xxpESP32/STC32G_Power_USB/硬件电路/PCB图.png

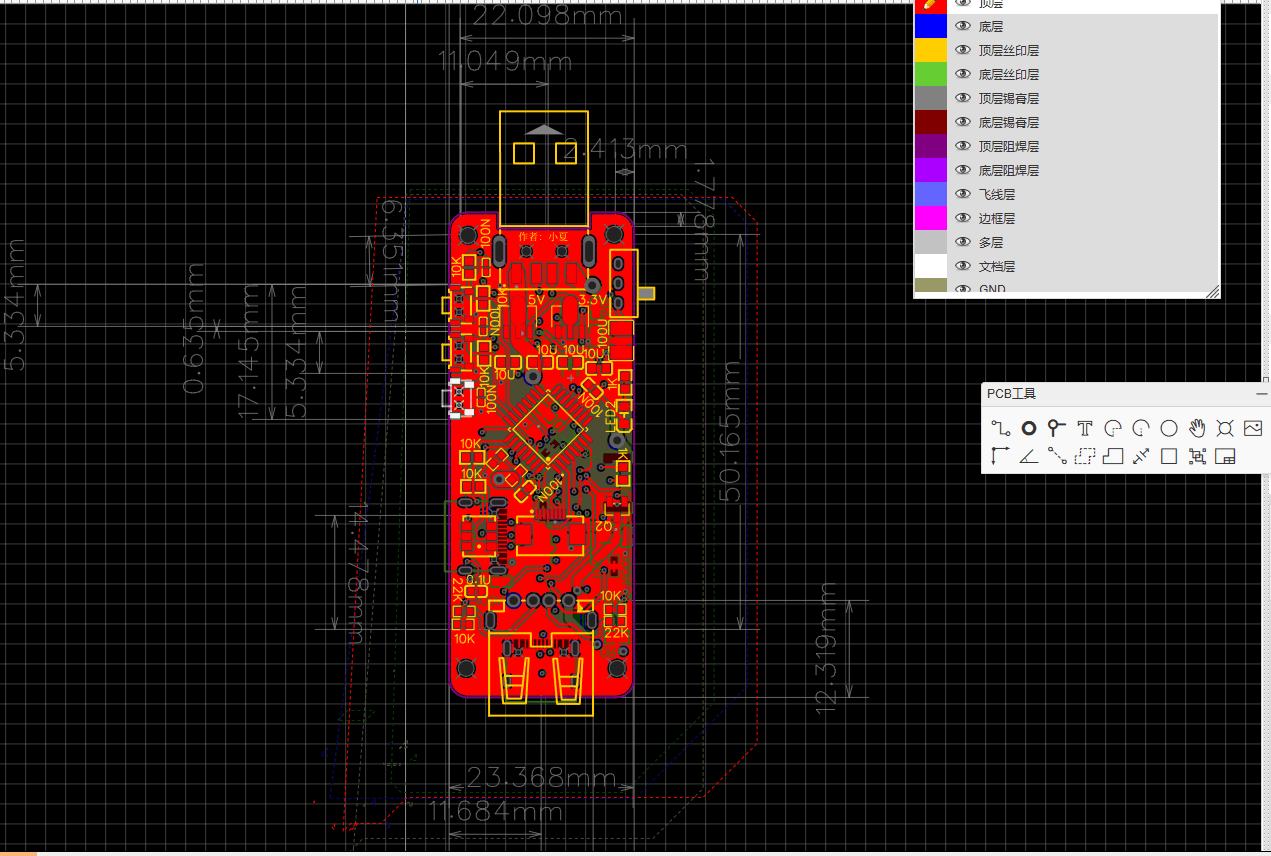
硬件电路/PCB图.png
