xxpESP32/STC32G_Power_USB/硬件电路/硬件原理图.png

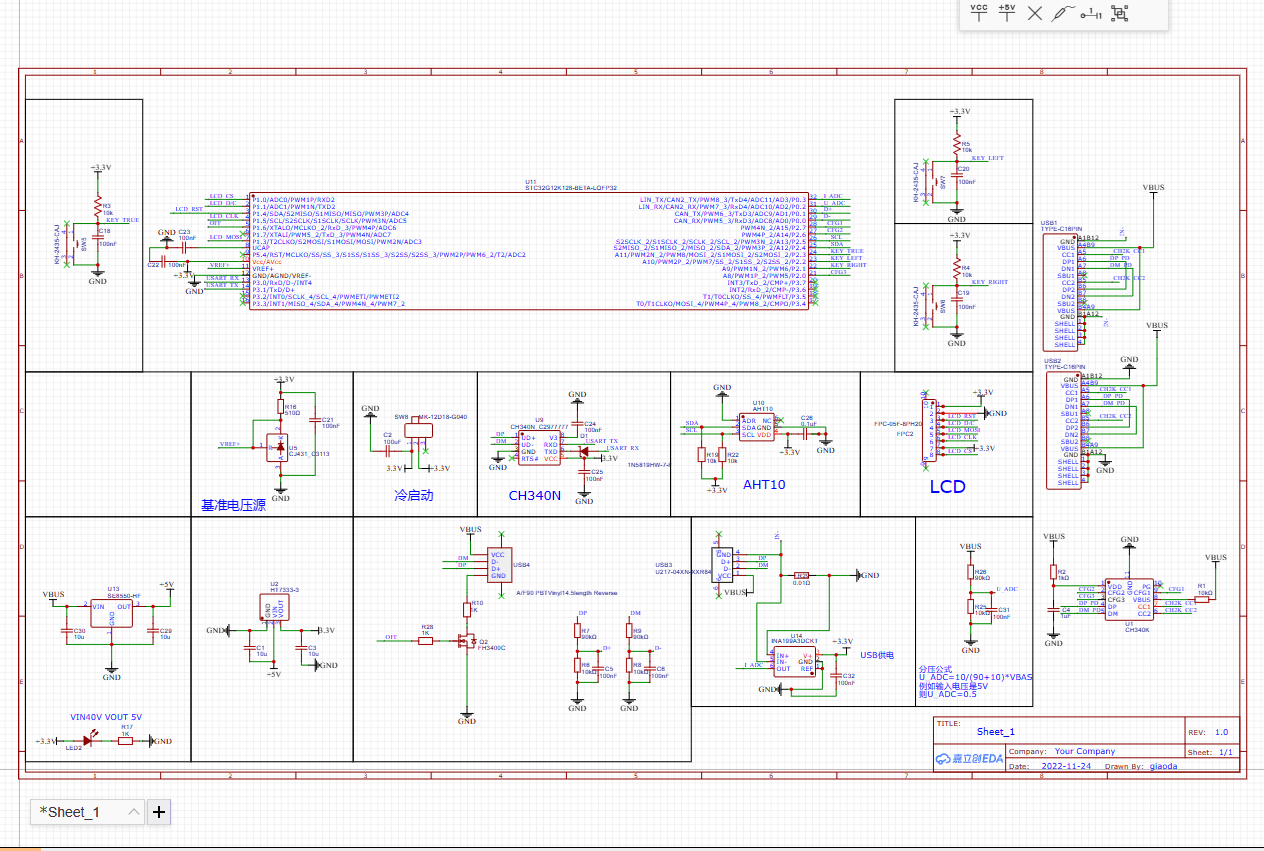
硬件电路/硬件原理图.png
