xxpESP32/STC32G_Power_USB/硬件电路/BOM_[STC32G12K128] V.2.0_2023-02-16.csv

ID | Name | Designator | Footprint | Quantity | Manufacturer Part | Manufacturer | Supplier | Supplier Part | Price | Pins
1 | 10u | C1,C3,C29,C30 | C0603 | 4 |  |  |  |  |  | 2
2 | 100uF | C2 | C1210 | 1 | GRM32EE70G107ME19L | muRata(村田) | LCSC | C711057 | 2.1388 | 2
3 | 1uF | C4 | C0603 | 1 | CC0603KRX5R8BB105 | YAGEO | LCSC | C14664 | 0.0331 | 2
4 | 100nF | C5,C6,C21,C22,C23,C24,C25,C31,C32 | C0603 | 9 | CL10B104KC8NNNC | SAMSUNG | LCSC | C15725 | 0.0462 | 2
5 | 100nF | C18,C19,C20 | C0402 | 3 | GCM155R71C104KA55J | muRata(村田) | LCSC | C2655418 | 0.0395 | 2
6 | 0.1uF | C26 | C0603 | 1 | 0603BB104K500NGT | Knowles(楼氏) | LCSC | C2168571 | 30.36 | 2
7 | 1N5819HW-7-F | D1 | SOD-123_L2.8-W1.8-LS3.7-FD | 1 | 1N5819HW-7-F | DIODES | LCSC | C82544 | 0.1569 | 2
8 | FPC-05F-8PH20 | FPC2 | FPC-SMD_8P-P0.50_FPC-05F-8PH20 | 1 | FPC-05F-8PH20 | XUNPU(讯普) | LCSC | C2856797 | 0.5247 | 10
9 | 204-10SURD/S530-A3 | LED2 | LED0805-RD | 1 | 204-10SURD/S530-A3 | EVERLIGHT | LCSC | C99772 | 0.2313 | 2
10 | FH3400C | Q2 | SOT-23-3_L2.9-W1.3-P1.90-LS2.4-BR | 1 | FH3400C | 鑫飞宏 | LCSC | C2940037 | 0.2404 | 3
11 | 10kΩ | R1,R6,R8,R25 | R0603 | 4 | RMC06036.8K5%N | Tyohm | LCSC | C269697 | 0.019 | 2
12 | 1kΩ | R2 | R0603 | 1 | MCWF06R1001BTL | Multicomp | LCSC | C241300 | 1.4764 | 2
13 | 10k | R3,R4,R5,R19,R22 | R0603 | 5 |  |  |  |  |  | 2
14 | 90kΩ | R7,R9,R26 | R0603 | 3 | RMC06036.8K5%N | Tyohm | LCSC | C269697 | 0.019 | 2
15 | 1K | R10,R17,R28 | R0603 | 3 |  |  |  |  |  | 2
16 | 510Ω | R16 | R0603 | 1 | 0603WAJ0000T5E | UniOhm | LCSC | C15402 | 0.0067 | 2
17 | 0.01Ω | R29 | R2512 | 1 | FMF25JPJR010-LHL | PSA | LCSC | C105370 | 0.3029 | 2
18 | KH-2435-CAJ | SW5,SW6,SW7 | SW-SMD_KH-2435-CAJ | 3 | KH-2435-CAJ | kinghelm(金航标) | LCSC | C530669 | 0.2322 | 4
19 | MK-12D18-G040 | SW8 | SW-TH_MK-12D18-G040 | 1 | MK-12D18-G040 | G-Switch | LCSC | C963202 | 0.6701 | 3
20 | CH340K | U1 | ESOP-10_L4.9-W3.9-P1.00-LS6.2-BL-EP | 1 | CH340K | WCH(Jiangsu Qin Heng) | LCSC | C968586 | 4.46 | 11
21 | HT7333-3 | U2 | SOT-89-3_L4.5-W2.5-P1.50-LS4.2-BR | 1 | HT7333-3 | HOLTEK(台湾合泰/盛群) | LCSC | C84207 | 1.8944 | 3
22 | CJ431_C3113 | U5 | SOT-23-3_L2.9-W1.6-P1.90-LS2.8-BR | 1 | CJ431 | CJ | LCSC | C3113 | 0.2165 | 3
23 | CH340N_C2977777 | U9 | SOP-8_L4.9-W3.9-P1.27-LS6.0-BL | 1 | CH340N | WCH(南京沁恒) | LCSC | C2977777 | 3.19 | 8
24 | AHT10 | U10 | SENSOR-SMD_AHT10 | 1 | AHT10 | 广州奥松 | LCSC | C368909 | 4.85 | 6
25 | STC32G12K128-BETA-LQFP32 | U11 | LQFP-32_L7.0-W7.0-P0.80-LS9.0-BL | 1 | STC32G12K128-Beta-LQFP32 | STC(宏晶) | LCSC | C3020369 | 8.8 | 32
26 | SE8550-HF | U13 | SOT-89-3_L4.5-W2.5-P1.50-LS4.2-BR | 1 | SE8550-HF | SEAWARD | LCSC | C115012 | 0.9356 | 3
27 | INA199A3DCKT | U14 | SC-70-6_L2.1-W1.3-P0.65-LS2.1-BR | 1 | INA199A3DCKT | TI(德州仪器) | LCSC | C2155798 | 6.19 | 6
28 | TYPE-C16PIN | USB1,USB2 | USB-C-SMD_TYPE-C16PIN | 2 | TYPE-C16PIN | SHOU HAN | LCSC | C393939 | 1.3293 | 16
29 | U217-04XN-XXR84 | USB3 | USB-A-SMD_U217-041N-4BV81 | 1 | U217-041N-4BV81 | XKB Connectivity(中国星坤) | LCSC | C319178 | 0.3553 | 6
30 | A/F90 PBTVinyl14.5length Reverse | USB4 | USB-A-TH_USB-M-57 | 1 | A/F90 PBTVinyl14.5length Reverse | ValuePro | LCSC | C42662 | 0.5702 | 6
