xxpESP32/STC32G_Power_USB/(list of files, cad)

Other CAD files:
实战-电流计_V1.0.2/Objects/main.obj
实战-电流计_V1.0.2/Objects/uart1.obj
实战-电流计_V1.0.2/Objects/usart2.obj
实战-电流计_V1.0.2/Objects/AHT10.obj
实战-电流计_V1.0.2/Objects/Spi_Handler.obj
实战-电流计_V1.0.2/Objects/CH224K.obj
实战-电流计_V1.0.2/Objects/Pwm.obj
实战-电流计_V1.0.2/Objects/SYSTEM.obj
实战-电流计_V1.0.2/Objects/lcd_init.obj
实战-电流计_V1.0.2/Objects/ADC.obj
实战-电流计_V1.0.2/Objects/menu_Ui.obj
实战-电流计_V1.0.2/Objects/Timer.obj
实战-电流计_V1.0.2/Objects/lcd.obj
实战-电流计_V1.0.2/Objects/KEY.obj
实战-电流计_V1.0.2/Objects/menu.obj
实战-电流计_V1.0.2/Objects/I2C.obj
