xxpESP32/STC32G_Power_USB/实战-电流计_V1.0.2/LCD/lcdfont.h

#ifndef __LCDFONT_H
#define __LCDFONT_H 	   

const unsigned char code ascii_1206[][12]={

{0x00,0x00,0x00,0x00,0x00,0x00,0x00,0x00,0x00,0x00,0x00,0x00},/*" ",0*/
{0x00,0x00,0x04,0x04,0x04,0x04,0x04,0x00,0x00,0x04,0x00,0x00},/*"!",1*/
{0x14,0x14,0x0A,0x00,0x00,0x00,0x00,0x00,0x00,0x00,0x00,0x00},/*""",2*/
{0x00,0x00,0x0A,0x0A,0x1F,0x0A,0x0A,0x1F,0x0A,0x0A,0x00,0x00},/*"#",3*/
{0x00,0x04,0x0E,0x15,0x05,0x06,0x0C,0x14,0x15,0x0E,0x04,0x00},/*"$",4*/
{0x00,0x00,0x12,0x15,0x0D,0x15,0x2E,0x2C,0x2A,0x12,0x00,0x00},/*"%",5*/
{0x00,0x00,0x04,0x0A,0x0A,0x36,0x15,0x15,0x29,0x16,0x00,0x00},/*"&",6*/
{0x02,0x02,0x01,0x00,0x00,0x00,0x00,0x00,0x00,0x00,0x00,0x00},/*"'",7*/
{0x10,0x08,0x08,0x04,0x04,0x04,0x04,0x04,0x08,0x08,0x10,0x00},/*"(",8*/
{0x02,0x04,0x04,0x08,0x08,0x08,0x08,0x08,0x04,0x04,0x02,0x00},/*")",9*/
{0x00,0x00,0x00,0x04,0x15,0x0E,0x0E,0x15,0x04,0x00,0x00,0x00},/*"*",10*/
{0x00,0x00,0x00,0x08,0x08,0x3E,0x08,0x08,0x00,0x00,0x00,0x00},/*"+",11*/
{0x00,0x00,0x00,0x00,0x00,0x00,0x00,0x00,0x02,0x02,0x01,0x00},/*",",12*/
{0x00,0x00,0x00,0x00,0x00,0x3F,0x00,0x00,0x00,0x00,0x00,0x00},/*"-",13*/
{0x00,0x00,0x00,0x00,0x00,0x00,0x00,0x00,0x00,0x02,0x00,0x00},/*".",14*/
{0x00,0x20,0x10,0x10,0x08,0x08,0x04,0x04,0x02,0x02,0x01,0x00},/*"/",15*/
{0x00,0x00,0x0E,0x11,0x11,0x11,0x11,0x11,0x11,0x0E,0x00,0x00},/*"0",16*/
{0x00,0x00,0x04,0x06,0x04,0x04,0x04,0x04,0x04,0x0E,0x00,0x00},/*"1",17*/
{0x00,0x00,0x0E,0x11,0x11,0x08,0x04,0x02,0x01,0x1F,0x00,0x00},/*"2",18*/
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
0x40,0x8C,0x31,0x06,0x60,0x8C,0x31,0x06,0x7C,0x8C,0x31,0x06,0x70,0x8C,0x31,0x06,
0x30,0x8C,0x31,0x06,0x30,0x8C,0x31,0x06,0x30,0x8C,0x31,0x06,0x30,0x8C,0x31,0x06,
0x30,0x8C,0x31,0x36,0xB0,0xFF,0xFF,0x3F,0x00,0x00,0x00,0x00,0x00,0x00,0x00,0x00,/*"温",2*/
/* (32 X 32 , 宋体 )*/

"度",0x00,0x00,0x00,0x00,0x00,0x00,0x00,0x00,0x00,0x80,0x00,0x00,0x00,0x00,0x03,0x00,
0x00,0x00,0x07,0x08,0x20,0x00,0x02,0x1C,0xE0,0xFF,0xFF,0x3F,0x60,0x20,0x20,0x00,
0x60,0xE0,0xE0,0x00,0x60,0x60,0x60,0x00,0x60,0x60,0x60,0x0C,0xE0,0xFF,0xFF,0x1F,
0x60,0x60,0x60,0x00,0x60,0x60,0x60,0x00,0x60,0x60,0x60,0x00,0x60,0x60,0x60,0x00,
0x60,0xE0,0x7F,0x00,0x60,0x60,0x60,0x00,0x20,0x00,0x80,0x00,0x20,0xFC,0xFF,0x01,
0x30,0x20,0xC0,0x01,0x30,0x40,0xE0,0x00,0x30,0xC0,0x60,0x00,0x10,0x80,0x30,0x00,
0x10,0x00,0x1B,0x00,0x18,0x00,0x0E,0x00,0x08,0x00,0x1F,0x00,0x08,0xC0,0x79,0x00,
0x04,0x70,0xE0,0x1F,0x04,0x0E,0x00,0x1F,0xE2,0x01,0x00,0x08,0x00,0x00,0x00,0x00,/*"度",3*/
/* (32 X 32 , 宋体 )*/






/* (32 X 32 , 宋体 )*/	

};

#endif
