xxpESP32/STC32G_Power_USB/实战-电流计_V1.0.2/LCD/lcd_init.c

#include "lcd_init.h"
#include "system.h"
#include "SPI_Handler.h"

#define SYS_CLK 35000000L
//不准确延时函数



/******************************************************************************
      函数说明：LCD串行数据写入函数
      入口数据：dat  要写入的串行数据
      返回值：  无
******************************************************************************/
#if SOFTWARE

void LCD_Writ_Bus(u8 dat) 
{	
	u8 i;
	LCD_CS_Clr();
	for(i=0;i<8;i++)
	{			  
		LCD_SCLK_Clr();
		if(dat&0x80)
		{
		   LCD_MOSI_Set();
		}
		else
		{
		   LCD_MOSI_Clr();
		}
		LCD_SCLK_Set();
		dat<<=1;
	}	
  LCD_CS_Set();	
}
#else
void LCD_Writ_Bus(u8 dat){
	LCD_CS_Clr();
	SPDAT=dat;
	while(!SPIF);
	SPIF=1;
	LCD_CS_Set();	
}
#endif
/******************************************************************************
      函数说明：LCD写入数据
      入口数据：dat 写入的数据
      返回值：  无
******************************************************************************/
void LCD_WR_DATA8(u8 dat)
{
	LCD_Writ_Bus(dat);
}


/******************************************************************************
      函数说明：LCD写入数据
      入口数据：dat 写入的数据
      返回值：  无
******************************************************************************/
void LCD_WR_DATA(u16 dat)
{
	LCD_Writ_Bus(dat>>8);
	LCD_Writ_Bus(dat);
}


/******************************************************************************
      函数说明：LCD写入命令
      入口数据：dat 写入的命令
      返回值：  无
******************************************************************************/
void LCD_WR_REG(u8 dat)
{
	LCD_DC_Clr();//写命令
	LCD_Writ_Bus(dat);
	LCD_DC_Set();//写数据
}


/******************************************************************************
      函数说明：设置起始和结束地址
      入口数据：x1,x2 设置列的起始和结束地址
                y1,y2 设置行的起始和结束地址
      返回值：  无
******************************************************************************/

void LCD_Address_Set(u16 x1,u16 y1,u16 x2,u16 y2)
{
			if(USE_HORIZONTAL==0)
	{
		LCD_WR_REG(0x2a);//列地址设置
		LCD_WR_DATA(x1+52);
		LCD_WR_DATA(x2+52);
		LCD_WR_REG(0x2b);//行地址设置
		LCD_WR_DATA(y1+40);
		LCD_WR_DATA(y2+40);
		LCD_WR_REG(0x2c);//储存器写
	}
	else if(USE_HORIZONTAL==1)
	{
		LCD_WR_REG(0x2a);//列地址设置
		LCD_WR_DATA(x1+53);
		LCD_WR_DATA(x2+53);
		LCD_WR_REG(0x2b);//行地址设置
		LCD_WR_DATA(y1+40);
		LCD_WR_DATA(y2+40);
		LCD_WR_REG(0x2c);//储存器写
	}
	else if(USE_HORIZONTAL==2)
	{
		LCD_WR_REG(0x2a);//列地址设置
		LCD_WR_DATA(x1+40);
		LCD_WR_DATA(x2+40);
		LCD_WR_REG(0x2b);//行地址设置
		LCD_WR_DATA(y1+53);
		LCD_WR_DATA(y2+53);
		LCD_WR_REG(0x2c);//储存器写
	}
	else
	{
		LCD_WR_REG(0x2a);//列地址设置
		LCD_WR_DATA(x1+40);
		LCD_WR_DATA(x2+40);
		LCD_WR_REG(0x2b);//行地址设置
		LCD_WR_DATA(y1+52);
		LCD_WR_DATA(y2+52);
		LCD_WR_REG(0x2c);//储存器写
	}
}
/*
void LCD_Address_Set(u16 x1,u16 y1,u16 x2,u16 y2)
{
	if(USE_HORIZONTAL==0)
	{
		LCD_WR_REG(0x2a);//列地址设置
		LCD_WR_DATA(x1+26);
		LCD_WR_DATA(x2+26);
		LCD_WR_REG(0x2b);//行地址设置
		LCD_WR_DATA(y1+1);
		LCD_WR_DATA(y2+1);
		LCD_WR_REG(0x2c);//储存器写
	}
	else if(USE_HORIZONTAL==1)
	{
		LCD_WR_REG(0x2a);//列地址设置
		LCD_WR_DATA(x1+26);
		LCD_WR_DATA(x2+26);
		LCD_WR_REG(0x2b);//行地址设置
		LCD_WR_DATA(y1+1);
		LCD_WR_DATA(y2+1);
		LCD_WR_REG(0x2c);//储存器写
	}
	else if(USE_HORIZONTAL==2)
	{
		LCD_WR_REG(0x2a);//列地址设置
		LCD_WR_DATA(x1+1);
		LCD_WR_DATA(x2+1);
		LCD_WR_REG(0x2b);//行地址设置
		LCD_WR_DATA(y1+26);
		LCD_WR_DATA(y2+26);
		LCD_WR_REG(0x2c);//储存器写
	}
	else
	{
		LCD_WR_REG(0x2a);//列地址设置
		LCD_WR_DATA(x1+1);
		LCD_WR_DATA(x2+1);
		LCD_WR_REG(0x2b);//行地址设置
		LCD_WR_DATA(y1+26);
		LCD_WR_DATA(y2+26);
		LCD_WR_REG(0x2c);//储存器写
	}
}
*/
/******************************************************************************
      函数说明：LCD初始化函数
      入口数据：无
      返回值：  无
******************************************************************************/

void Lcd_Init(void)
{
#if SOFTWARE

#else
	SPI_Init();
#endif
	
	LCD_RES_Clr();//复位
	Delay_ms(100);
	LCD_RES_Set();
	Delay_ms(100);
	
	//LCD_BLK_Set();//打开背光
  Delay_ms(100);
	
	LCD_WR_REG(0x11); 
	delay_ms(120); 
	LCD_WR_REG(0x36); 
	if(USE_HORIZONTAL==0)LCD_WR_DATA8(0x00);
	else if(USE_HORIZONTAL==1)LCD_WR_DATA8(0xC0);
	else if(USE_HORIZONTAL==2)LCD_WR_DATA8(0x70);
	else LCD_WR_DATA8(0xA0);

	LCD_WR_REG(0x3A);
	LCD_WR_DATA8(0x05);

	LCD_WR_REG(0xB2);
	LCD_WR_DATA8(0x0C);
	LCD_WR_DATA8(0x0C);
	LCD_WR_DATA8(0x00);
	LCD_WR_DATA8(0x33);
	LCD_WR_DATA8(0x33); 

	LCD_WR_REG(0xB7); 
	LCD_WR_DATA8(0x35);  

	LCD_WR_REG(0xBB);
	LCD_WR_DATA8(0x19);

	LCD_WR_REG(0xC0);
	LCD_WR_DATA8(0x2C);

	LCD_WR_REG(0xC2);
	LCD_WR_DATA8(0x01);

	LCD_WR_REG(0xC3);
	LCD_WR_DATA8(0x12);   

	LCD_WR_REG(0xC4);
	LCD_WR_DATA8(0x20);  

	LCD_WR_REG(0xC6); 
	LCD_WR_DATA8(0x0F);    

	LCD_WR_REG(0xD0); 
	LCD_WR_DATA8(0xA4);
	LCD_WR_DATA8(0xA1);

	LCD_WR_REG(0xE0);
	LCD_WR_DATA8(0xD0);
	LCD_WR_DATA8(0x04);
	LCD_WR_DATA8(0x0D);
	LCD_WR_DATA8(0x11);
	LCD_WR_DATA8(0x13);
	LCD_WR_DATA8(0x2B);
	LCD_WR_DATA8(0x3F);
	LCD_WR_DATA8(0x54);
	LCD_WR_DATA8(0x4C);
	LCD_WR_DATA8(0x18);
	LCD_WR_DATA8(0x0D);
	LCD_WR_DATA8(0x0B);
	LCD_WR_DATA8(0x1F);
	LCD_WR_DATA8(0x23);

	LCD_WR_REG(0xE1);
	LCD_WR_DATA8(0xD0);
	LCD_WR_DATA8(0x04);
	LCD_WR_DATA8(0x0C);
	LCD_WR_DATA8(0x11);
	LCD_WR_DATA8(0x13);
	LCD_WR_DATA8(0x2C);
	LCD_WR_DATA8(0x3F);
	LCD_WR_DATA8(0x44);
	LCD_WR_DATA8(0x51);
	LCD_WR_DATA8(0x2F);
	LCD_WR_DATA8(0x1F);
	LCD_WR_DATA8(0x1F);
	LCD_WR_DATA8(0x20);
	LCD_WR_DATA8(0x23);

	LCD_WR_REG(0x21); 

	LCD_WR_REG(0x29); 
} 
/*
void Lcd_Init(void)
{
	//SPI_Init();
	
	LCD_RES_Clr();//复位
	Delay_ms(100);
	LCD_RES_Set();
	Delay_ms(100);
	
	//LCD_BLK_Set();//打开背光
  Delay_ms(100);
	LCD_WR_REG(0x11);     //Sleep out
	delay_ms(120);                //Delay 120ms
	LCD_WR_REG(0xB1);     //Normal mode
	LCD_WR_DATA8(0x05);   
	LCD_WR_DATA8(0x3C);   
	LCD_WR_DATA8(0x3C);   
	LCD_WR_REG(0xB2);     //Idle mode
	LCD_WR_DATA8(0x05);   
	LCD_WR_DATA8(0x3C);   
	LCD_WR_DATA8(0x3C);   
	LCD_WR_REG(0xB3);     //Partial mode
	LCD_WR_DATA8(0x05);   
	LCD_WR_DATA8(0x3C);   
	LCD_WR_DATA8(0x3C);   
	LCD_WR_DATA8(0x05);   
	LCD_WR_DATA8(0x3C);   
	LCD_WR_DATA8(0x3C);   
	LCD_WR_REG(0xB4);     //Dot inversion
	LCD_WR_DATA8(0x03);   
	LCD_WR_REG(0xC0);     //AVDD GVDD
	LCD_WR_DATA8(0xAB);   
	LCD_WR_DATA8(0x0B);   
	LCD_WR_DATA8(0x04);   
	LCD_WR_REG(0xC1);     //VGH VGL
	LCD_WR_DATA8(0xC5);   //C0
	LCD_WR_REG(0xC2);     //Normal Mode
	LCD_WR_DATA8(0x0D);   
	LCD_WR_DATA8(0x00);   
	LCD_WR_REG(0xC3);     //Idle
	LCD_WR_DATA8(0x8D);   
	LCD_WR_DATA8(0x6A);   
	LCD_WR_REG(0xC4);     //Partial+Full
	LCD_WR_DATA8(0x8D);   
	LCD_WR_DATA8(0xEE);   
	LCD_WR_REG(0xC5);     //VCOM
	LCD_WR_DATA8(0x0F);   
	LCD_WR_REG(0xE0);     //positive gamma
	LCD_WR_DATA8(0x07);   
	LCD_WR_DATA8(0x0E);   
	LCD_WR_DATA8(0x08);   
	LCD_WR_DATA8(0x07);   
	LCD_WR_DATA8(0x10);   
	LCD_WR_DATA8(0x07);   
	LCD_WR_DATA8(0x02);   
	LCD_WR_DATA8(0x07);   
	LCD_WR_DATA8(0x09);   
	LCD_WR_DATA8(0x0F);   
	LCD_WR_DATA8(0x25);   
	LCD_WR_DATA8(0x36);   
	LCD_WR_DATA8(0x00);   
	LCD_WR_DATA8(0x08);   
	LCD_WR_DATA8(0x04);   
	LCD_WR_DATA8(0x10);   
	LCD_WR_REG(0xE1);     //negative gamma
	LCD_WR_DATA8(0x0A);   
	LCD_WR_DATA8(0x0D);   
	LCD_WR_DATA8(0x08);   
	LCD_WR_DATA8(0x07);   
	LCD_WR_DATA8(0x0F);   
	LCD_WR_DATA8(0x07);   
	LCD_WR_DATA8(0x02);   
	LCD_WR_DATA8(0x07);   
	LCD_WR_DATA8(0x09);   
	LCD_WR_DATA8(0x0F);   
	LCD_WR_DATA8(0x25);   
	LCD_WR_DATA8(0x35);   
	LCD_WR_DATA8(0x00);   
	LCD_WR_DATA8(0x09);   
	LCD_WR_DATA8(0x04);   
	LCD_WR_DATA8(0x10);
		 
	LCD_WR_REG(0xFC);    
	LCD_WR_DATA8(0x80);  
		
	LCD_WR_REG(0x3A);     
	LCD_WR_DATA8(0x05);   
	LCD_WR_REG(0x36);
	if(USE_HORIZONTAL==0)LCD_WR_DATA8(0x08);
	else if(USE_HORIZONTAL==1)LCD_WR_DATA8(0xC8);
	else if(USE_HORIZONTAL==2)LCD_WR_DATA8(0x78);
	else LCD_WR_DATA8(0xA8);   
	LCD_WR_REG(0x21);     //Display inversion
	LCD_WR_REG(0x29);     //Display on
	LCD_WR_REG(0x2A);     //Set Column Address
	LCD_WR_DATA8(0x00);   
	LCD_WR_DATA8(0x1A);  //26  
	LCD_WR_DATA8(0x00);   
	LCD_WR_DATA8(0x69);   //105 
	LCD_WR_REG(0x2B);     //Set Page Address
	LCD_WR_DATA8(0x00);   
	LCD_WR_DATA8(0x01);    //1
	LCD_WR_DATA8(0x00);   
	LCD_WR_DATA8(0xA0);    //160
	LCD_WR_REG(0x2C); 

}

*/
