xxpESP32/STC32G_Power_USB/实战-电流计_V1.0.2/LCD/pic.h

#ifndef __PIC_H
#define __PIC_H

const unsigned char gImage_Begin[144] = { /* 0X10,0X10,0X00,0X06,0X00,0X0C,0X01,0X1B, */
0X00,0X00,0X00,0X00,0X00,0X00,0X00,0X00,0X00,0X00,0X00,0X00,0XF8,0X00,0X00,0X00,
0X00,0X00,0X00,0X00,0X00,0X00,0X00,0X00,0XF8,0X00,0XF8,0X00,0X00,0X00,0X00,0X00,
0X00,0X00,0X00,0X00,0XF8,0X00,0XF8,0X00,0XF8,0X00,0X00,0X00,0X00,0X00,0X00,0X00,
0XF8,0X00,0XF8,0X00,0XF8,0X00,0XF8,0X00,0X00,0X00,0X00,0X00,0XF8,0X00,0XF8,0X00,
0XF8,0X00,0XF8,0X00,0XF8,0X00,0XF8,0X00,0XF8,0X00,0XF8,0X00,0XF8,0X00,0XF8,0X00,
0XF8,0X00,0XF8,0X00,0XF8,0X00,0XF8,0X00,0XF8,0X00,0XF8,0X00,0X00,0X00,0X00,0X00,
0XF8,0X00,0XF8,0X00,0XF8,0X00,0X00,0X00,0X00,0X00,0X00,0X00,0XF8,0X00,0XF8,0X00,
0X00,0X00,0X00,0X00,0X00,0X00,0X00,0X00,0XF8,0X00,0X00,0X00,0X00,0X00,0X00,0X00,
0X00,0X00,0X00,0X00,0X00,0X00,0X00,0X00,0X00,0X00,0X00,0X00,0X00,0X00,0X00,0X00,
};
extern const unsigned char gImage_stop[144] = { /* 0X10,0X10,0X00,0X06,0X00,0X0C,0X01,0X1B, */
0X00,0X00,0X00,0X00,0X00,0X00,0X00,0X00,0X00,0X00,0X00,0X00,0X07,0XE0,0X07,0XE0,
0X00,0X00,0X00,0X00,0X07,0XE0,0X07,0XE0,0X07,0XE0,0X07,0XE0,0X00,0X00,0X00,0X00,
0X07,0XE0,0X07,0XE0,0X07,0XE0,0X07,0XE0,0X00,0X00,0X00,0X00,0X07,0XE0,0X07,0XE0,
0X07,0XE0,0X07,0XE0,0X00,0X00,0X00,0X00,0X07,0XE0,0X07,0XE0,0X07,0XE0,0X07,0XE0,
0X00,0X00,0X00,0X00,0X07,0XE0,0X07,0XE0,0X07,0XE0,0X07,0XE0,0X00,0X00,0X00,0X00,
0X07,0XE0,0X07,0XE0,0X07,0XE0,0X07,0XE0,0X00,0X00,0X00,0X00,0X07,0XE0,0X07,0XE0,
0X07,0XE0,0X07,0XE0,0X00,0X00,0X00,0X00,0X07,0XE0,0X07,0XE0,0X07,0XE0,0X07,0XE0,
0X00,0X00,0X00,0X00,0X07,0XE0,0X07,0XE0,0X07,0XE0,0X07,0XE0,0X00,0X00,0X00,0X00,
0X07,0XE0,0X07,0XE0,0X00,0X00,0X00,0X00,0X00,0X00,0X00,0X00,0X00,0X00,0X00,0X00,
};









#endif
